Tee6/LeslieSpeaker/README.md

# LeslieSpeaker
Im Rahmen des HWE Projekts wurde ein Leslie Lautsprecher realisiert. Teammitglieder: Pius Bickel, Niko Leimegger

Dokumentation unter: "Dokumentation und Projektanfrage/Leslie_Speaker_Doku_Bickel_Leimegger.pdf"
