Tee6/LeslieSpeaker/Gehäuse/SolidWorks/gehause.SLDASM

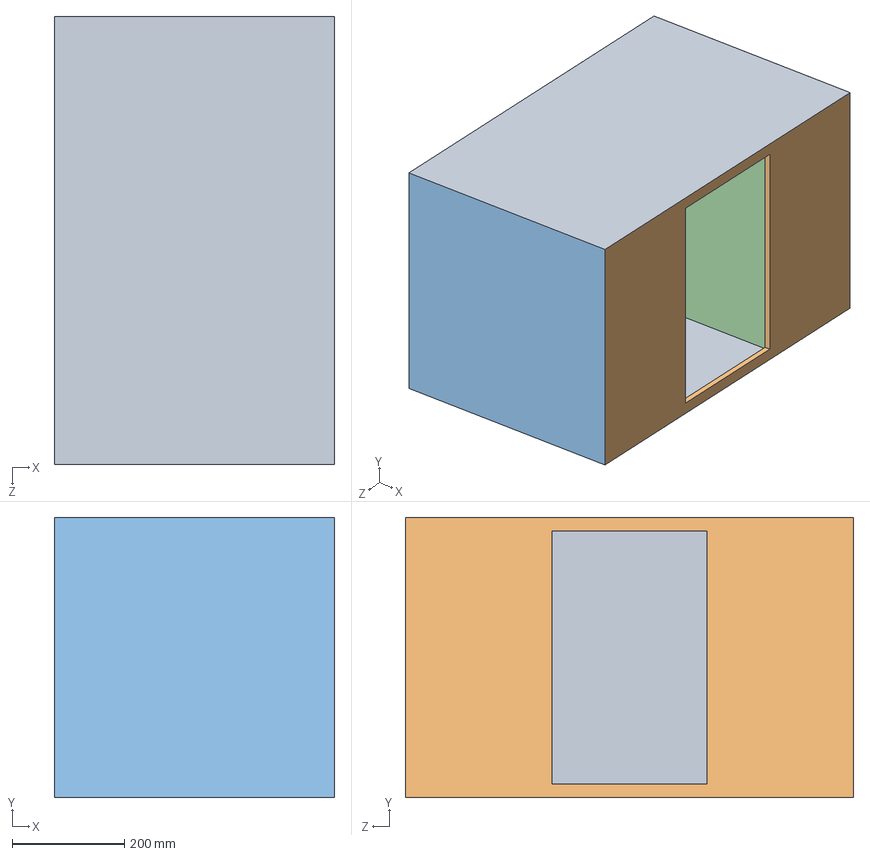
[picture p33: CAD file, 2023-06-22]
Gehäuse/SolidWorks/gehause.SLDASM
500.0 x 500.0 x 800.0 mm
case_01 x 3
case_02
case_03 x 2
case_04 x 2
