Tee6/LeslieSpeaker/Gehäuse/SolidWorks/case_01.SLDPRT

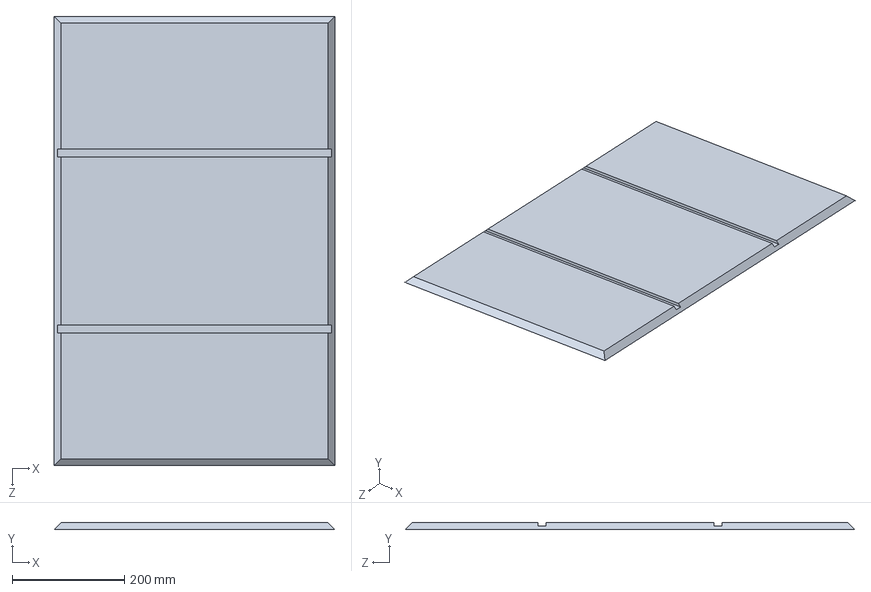
[picture p34: CAD file, 2023-06-22]
Gehäuse/SolidWorks/case_01.SLDPRT
500.0 x 12.0 x 800.0 mm
