Tee6/LeslieSpeaker/Gehäuse/SolidWorks/case_03.SLDPRT

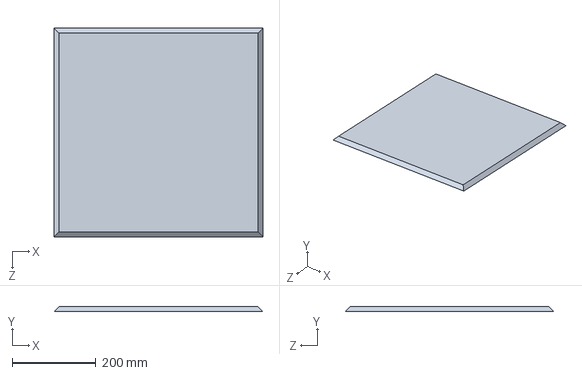
[picture p35: CAD file, 2023-06-22]
Gehäuse/SolidWorks/case_03.SLDPRT
500.0 x 12.0 x 500.0 mm
