Tee6/LeslieSpeaker/Gehäuse/SolidWorks/case_04.SLDPRT

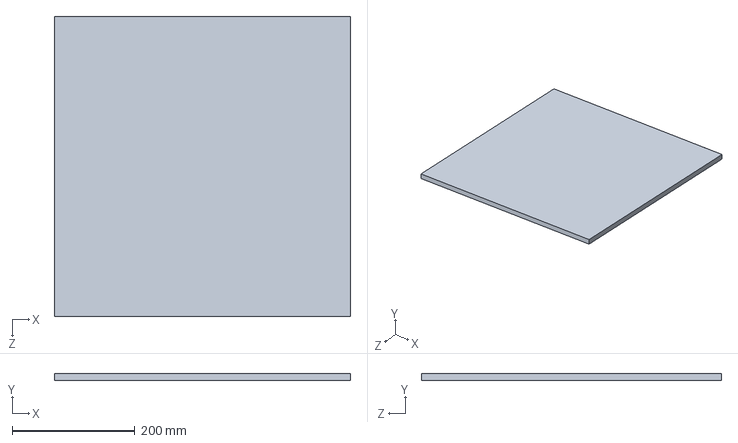
[picture p36: CAD file, 2023-06-22]
Gehäuse/SolidWorks/case_04.SLDPRT
482.0 x 12.0 x 488.0 mm
