Tee6/LeslieSpeaker/Gehäuse/SolidWorks/case_02.SLDPRT

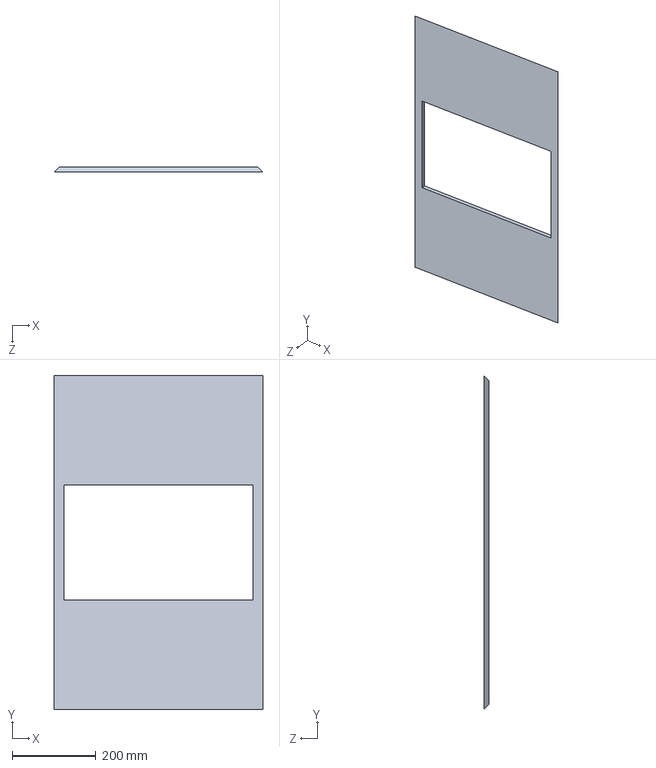
[picture p37: CAD file, 2023-06-22]
Gehäuse/SolidWorks/case_02.SLDPRT
500.0 x 800.0 x 12.0 mm
