Tee6/LeslieSpeaker/Gehäuse/SolidWorks/case_backup.SLDPRT

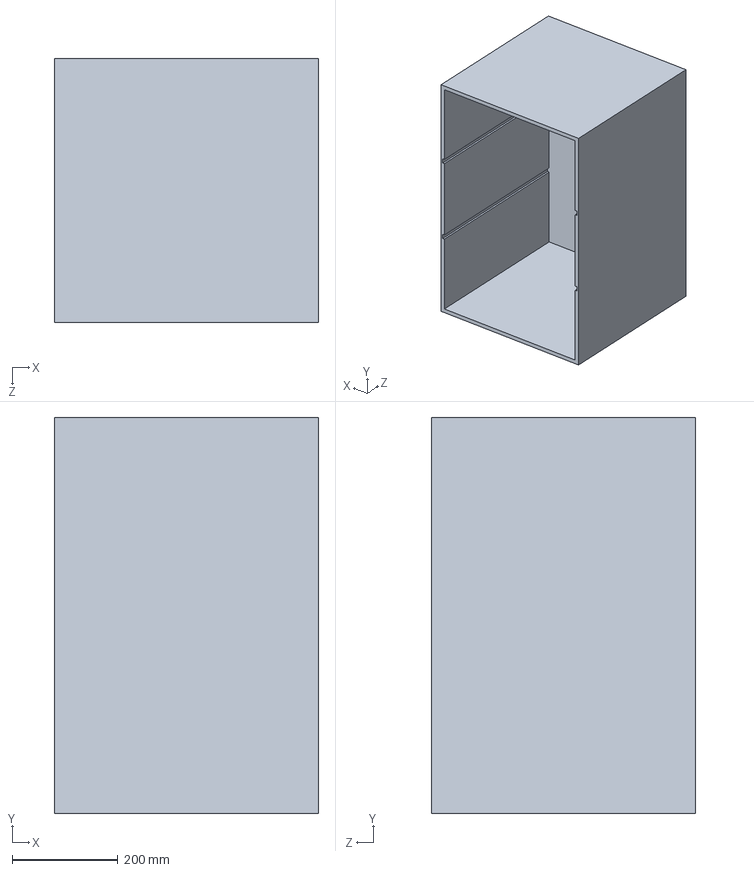
[picture p38: CAD file, 2023-06-22]
Gehäuse/SolidWorks/case_backup.SLDPRT
500.0 x 750.0 x 500.0 mm
