Tee6/LeslieSpeaker/(list of files, cad)

Other CAD files:
Gehäuse/SolidWorks/Außenwand.SLDDRW
Gehäuse/SolidWorks/Front.SLDDRW
Gehäuse/SolidWorks/Oben.SLDDRW
Gehäuse/SolidWorks/zwischenwand.SLDDRW
