Tee6/LeslieSpeaker/Gehäuse/PDFs/Außenwand.pdf

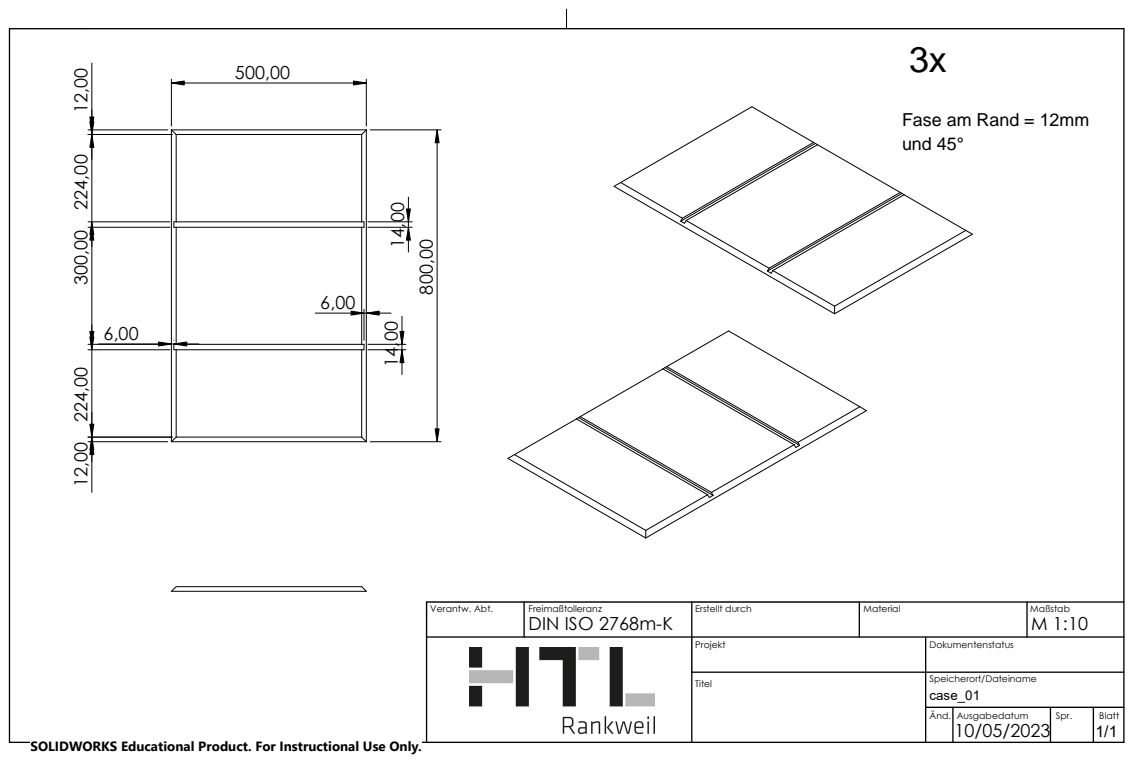
[picture p39: page 1]
6,00 ³⁰⁰,00 224,00 224,00

Verantw. Abt. | Freimaßtolleranz DIN ISO 2768m-K | Erstellt durch | Material | Maßstab M 1:10

Projekt | Dokumentenstatus

Titel | Speicherort/Dateiname case_01

Änd. | 10/05/2023 | Spr. | Blatt Ausgabedatum 1/1

SOLIDWORKS Educational Product. For Instructional Use Only.
