Tee6/LeslieSpeaker/Gehäuse/PDFs/front.pdf

500,00 262,00 | 452,00 | 24,00 276,00

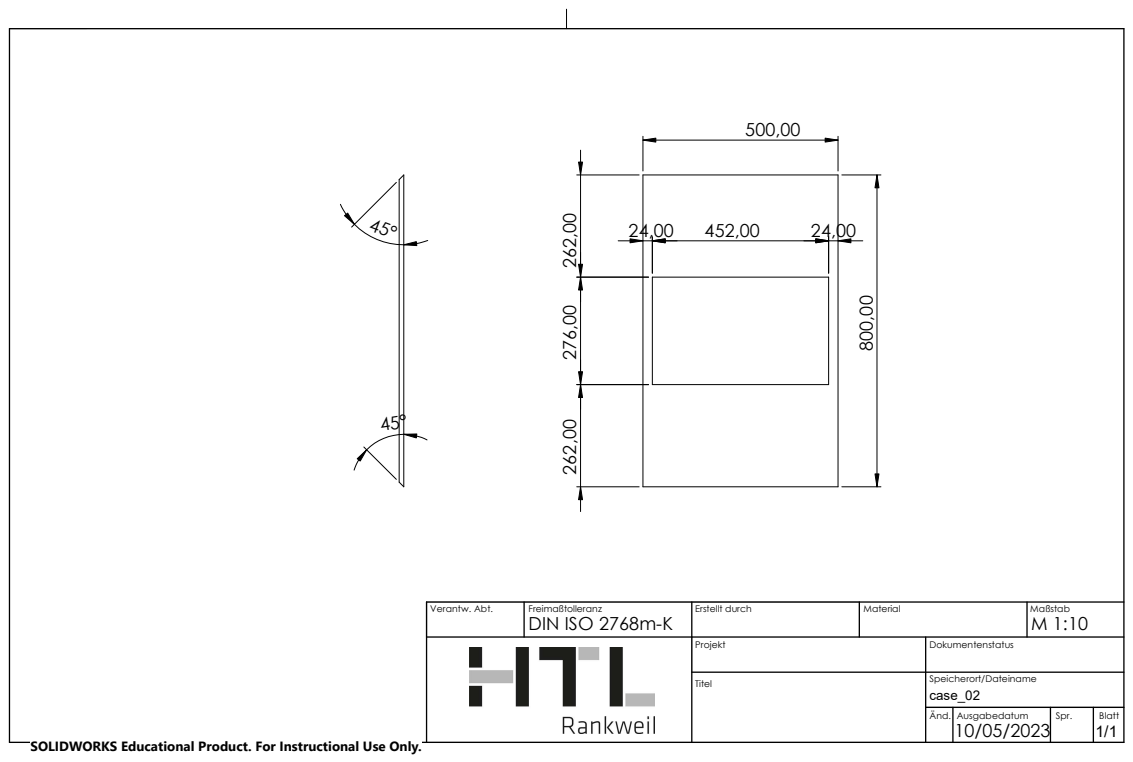
[picture p40: page 1]
M 1:10 ⁸⁰⁰,00

Verantw. Abt. | Freimaßtolleranz DIN ISO 2768m-K | Erstellt durch | Material | Maßstab

Projekt | Dokumentenstatus

Titel | Speicherort/Dateiname case_02

Änd. | 10/05/2023 | Spr. | Blatt Ausgabedatum 1/1

SOLIDWORKS Educational Product. For Instructional Use Only.
