Tee6/LeslieSpeaker/Motorsteuerung/Motor.asc

ArduinoPin: voltage; PULSE(0 5 0 1ns 1ns 5us 20us 10000)
C1: cap; 470µF
D1: diode; 1N4148
L1: ind; 1mH
Q1: npn
R1: res; 4k7
R2: res; 100R
V2: voltage; 12V
Named nets: 0
.tran 200ms
