Tee6/LeslieSpeaker/Verstärker/LTSpiceAmp/Verstaerker.asc

C3: polcap; 100µF
C4: cap; 470µF
C5: cap; 470µF
Q1: npn; FZT849
Q2: pnp; 2SAR533P
R3: res; 4
R4: res; 100k
R5: res; 20k
R6: res; 600k
R7: res; 1k
R11: res; 0.1R
R12: res; 0.1R
U1: UniversalOpamp2
U2: UniversalOpamp2
V1: voltage; 24V
Vsig: voltage; SINE(0 0.02 20k 0 0 0 100); AC 1 0
Named nets: +Vcc, 0, Signal, PreAmplified, -Vcc, Rueck, VGND, out
.tran 1ms
OpAmp Stage A=10
R5 = Potentiometer
Power Supply / Signal
Class AB Endstufe
