Tee6/LeslieSpeaker/Verstärker/EagleAmp/Amplifier_AB_V1.brd

## EAGLE design Verstärker/EagleAmp/Amplifier_AB_V1.brd (2023-06-22)

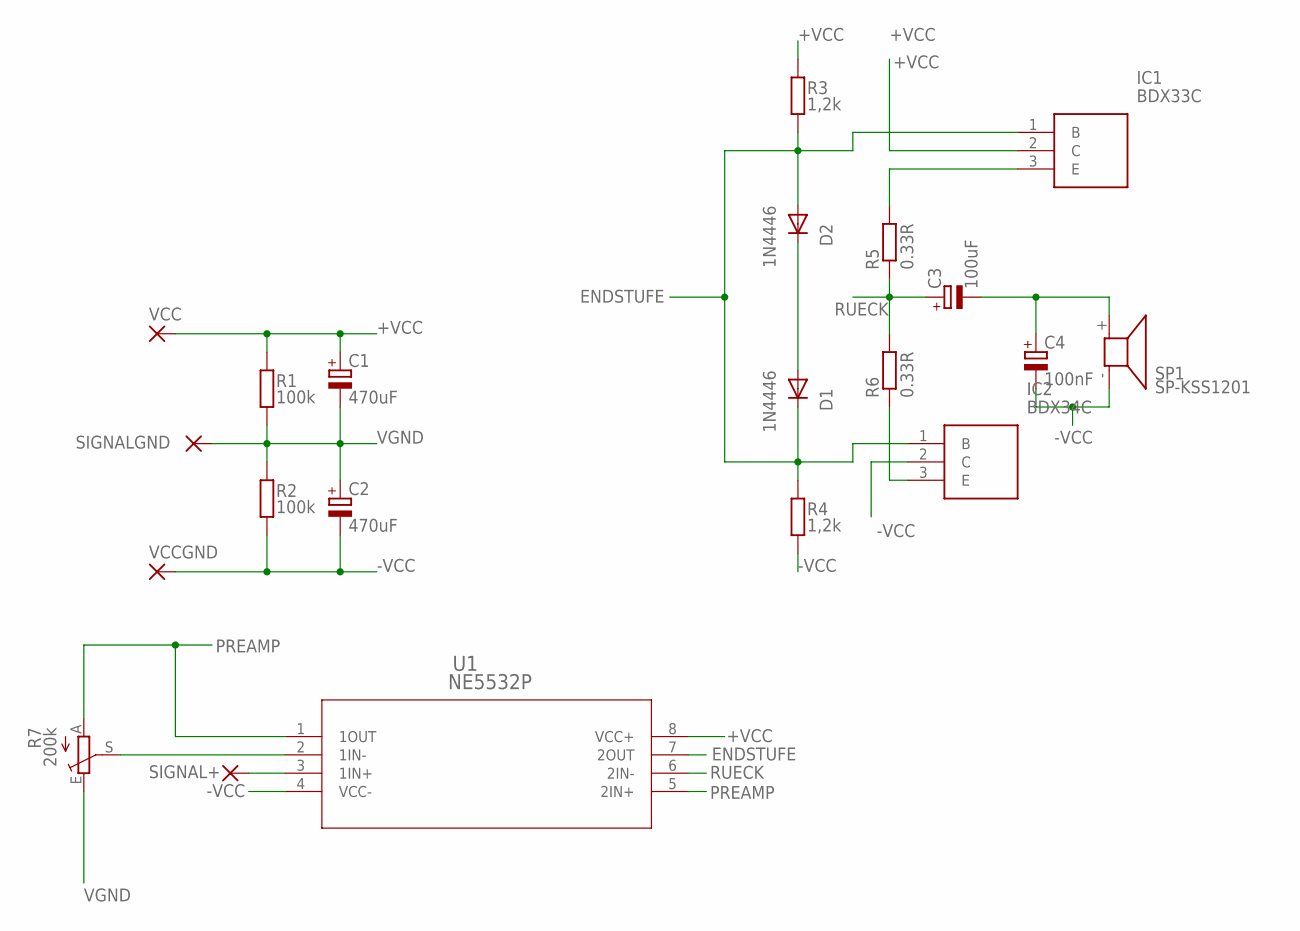
[picture p41: schematic Amplifier_AB_V1.sch]

Parts:
C1, C2: 470uF; 2,5-5
C3: 100uF; 5-10,5
C4: 100nF; 5-10,5
D1, D2: 1N4446; DO35-10
IC1: BDX33C; TO270P460X1020X2008-3P
IC2: BDX34C; TO270P460X1020X2008-3P
R1, R2: 100k; 0207/10
R3, R4: 1,2k; 0207/10
R5, R6: 0.33R; 0309/12
R7: 200k; CT6
SIGNAL+: 2,15/1,0
SIGNALGND: 2,15/1,0
SP1: SP-KSS1201
U1: NE5532P; P8
VCC: 2,15/1,0
VCCGND: 2,15/1,0

Connections:
+VCC: C1.+, IC1.2 (C), R1.2, R3.2, U1.8 (VCC+), VCC.1
-VCC: C2.-, C4.-, IC2.2 (C), R2.1, R4.1, SP1.- (2), U1.4 (VCC-), VCCGND.1
ENDSTUFE: D1.C, D2.A, IC1.1 (B), IC2.1 (B), R3.1, R4.2, U1.7 (2OUT)
unnamed: IC1.3 (E), R5.2
unnamed: R7.S, U1.2 (1IN-)
unnamed: C3.-, C4.+, SP1.+ (1)
unnamed: D1.A, D2.C
unnamed: IC2.3 (E), R6.1
unnamed: SIGNAL+.1, U1.3 (1IN+)
PREAMP: R7.A, U1.1 (1OUT), U1.5 (2IN+)
RUECK: C3.+, R5.1, R6.2, U1.6 (2IN-)
VGND: C1.-, C2.+, R1.1, R2.2, R7.E, SIGNALGND.1

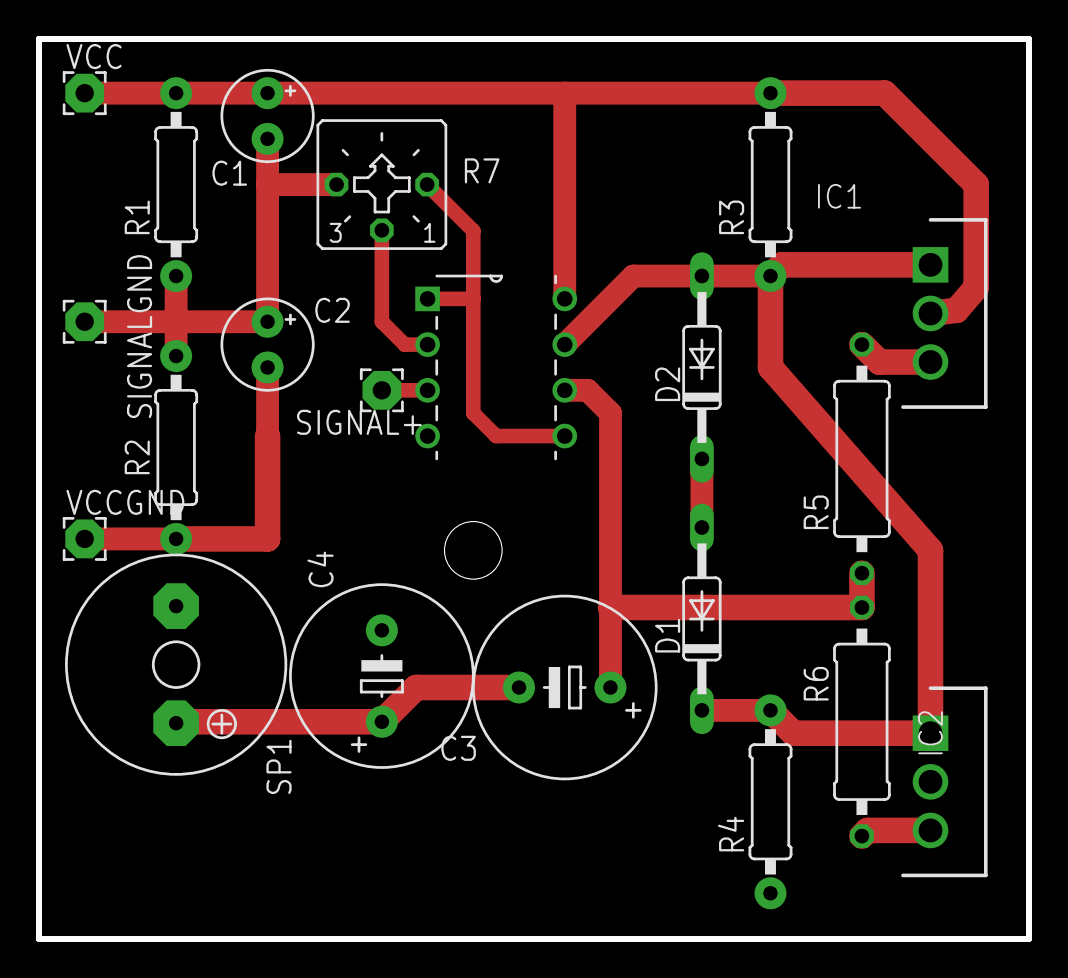
[picture p42: board Amplifier_AB_V1.brd from above]

Board: 2 copper layers, 55.0 x 50.0 mm, 21 parts (0 on the bottom side), 12 nets.
